ironsteel/apple-ice/README.md

# Apple-iCE

## Apple II peripheral card prototype which aims to be multi purpose

# Work in progess
