ironsteel/apple-ice/rtl/liron/README.md

Liron clone for the Apple ][ iCE board
============

## Introduction

RTL of the liron card clone based on Steve Chamberlin's initial design
with some minor tweaks.
