ironsteel/apple-ice/hardware/apple-ice.kicad_pcb

## KiCad design hardware/apple-ice.kicad_pcb (2021-10-15)

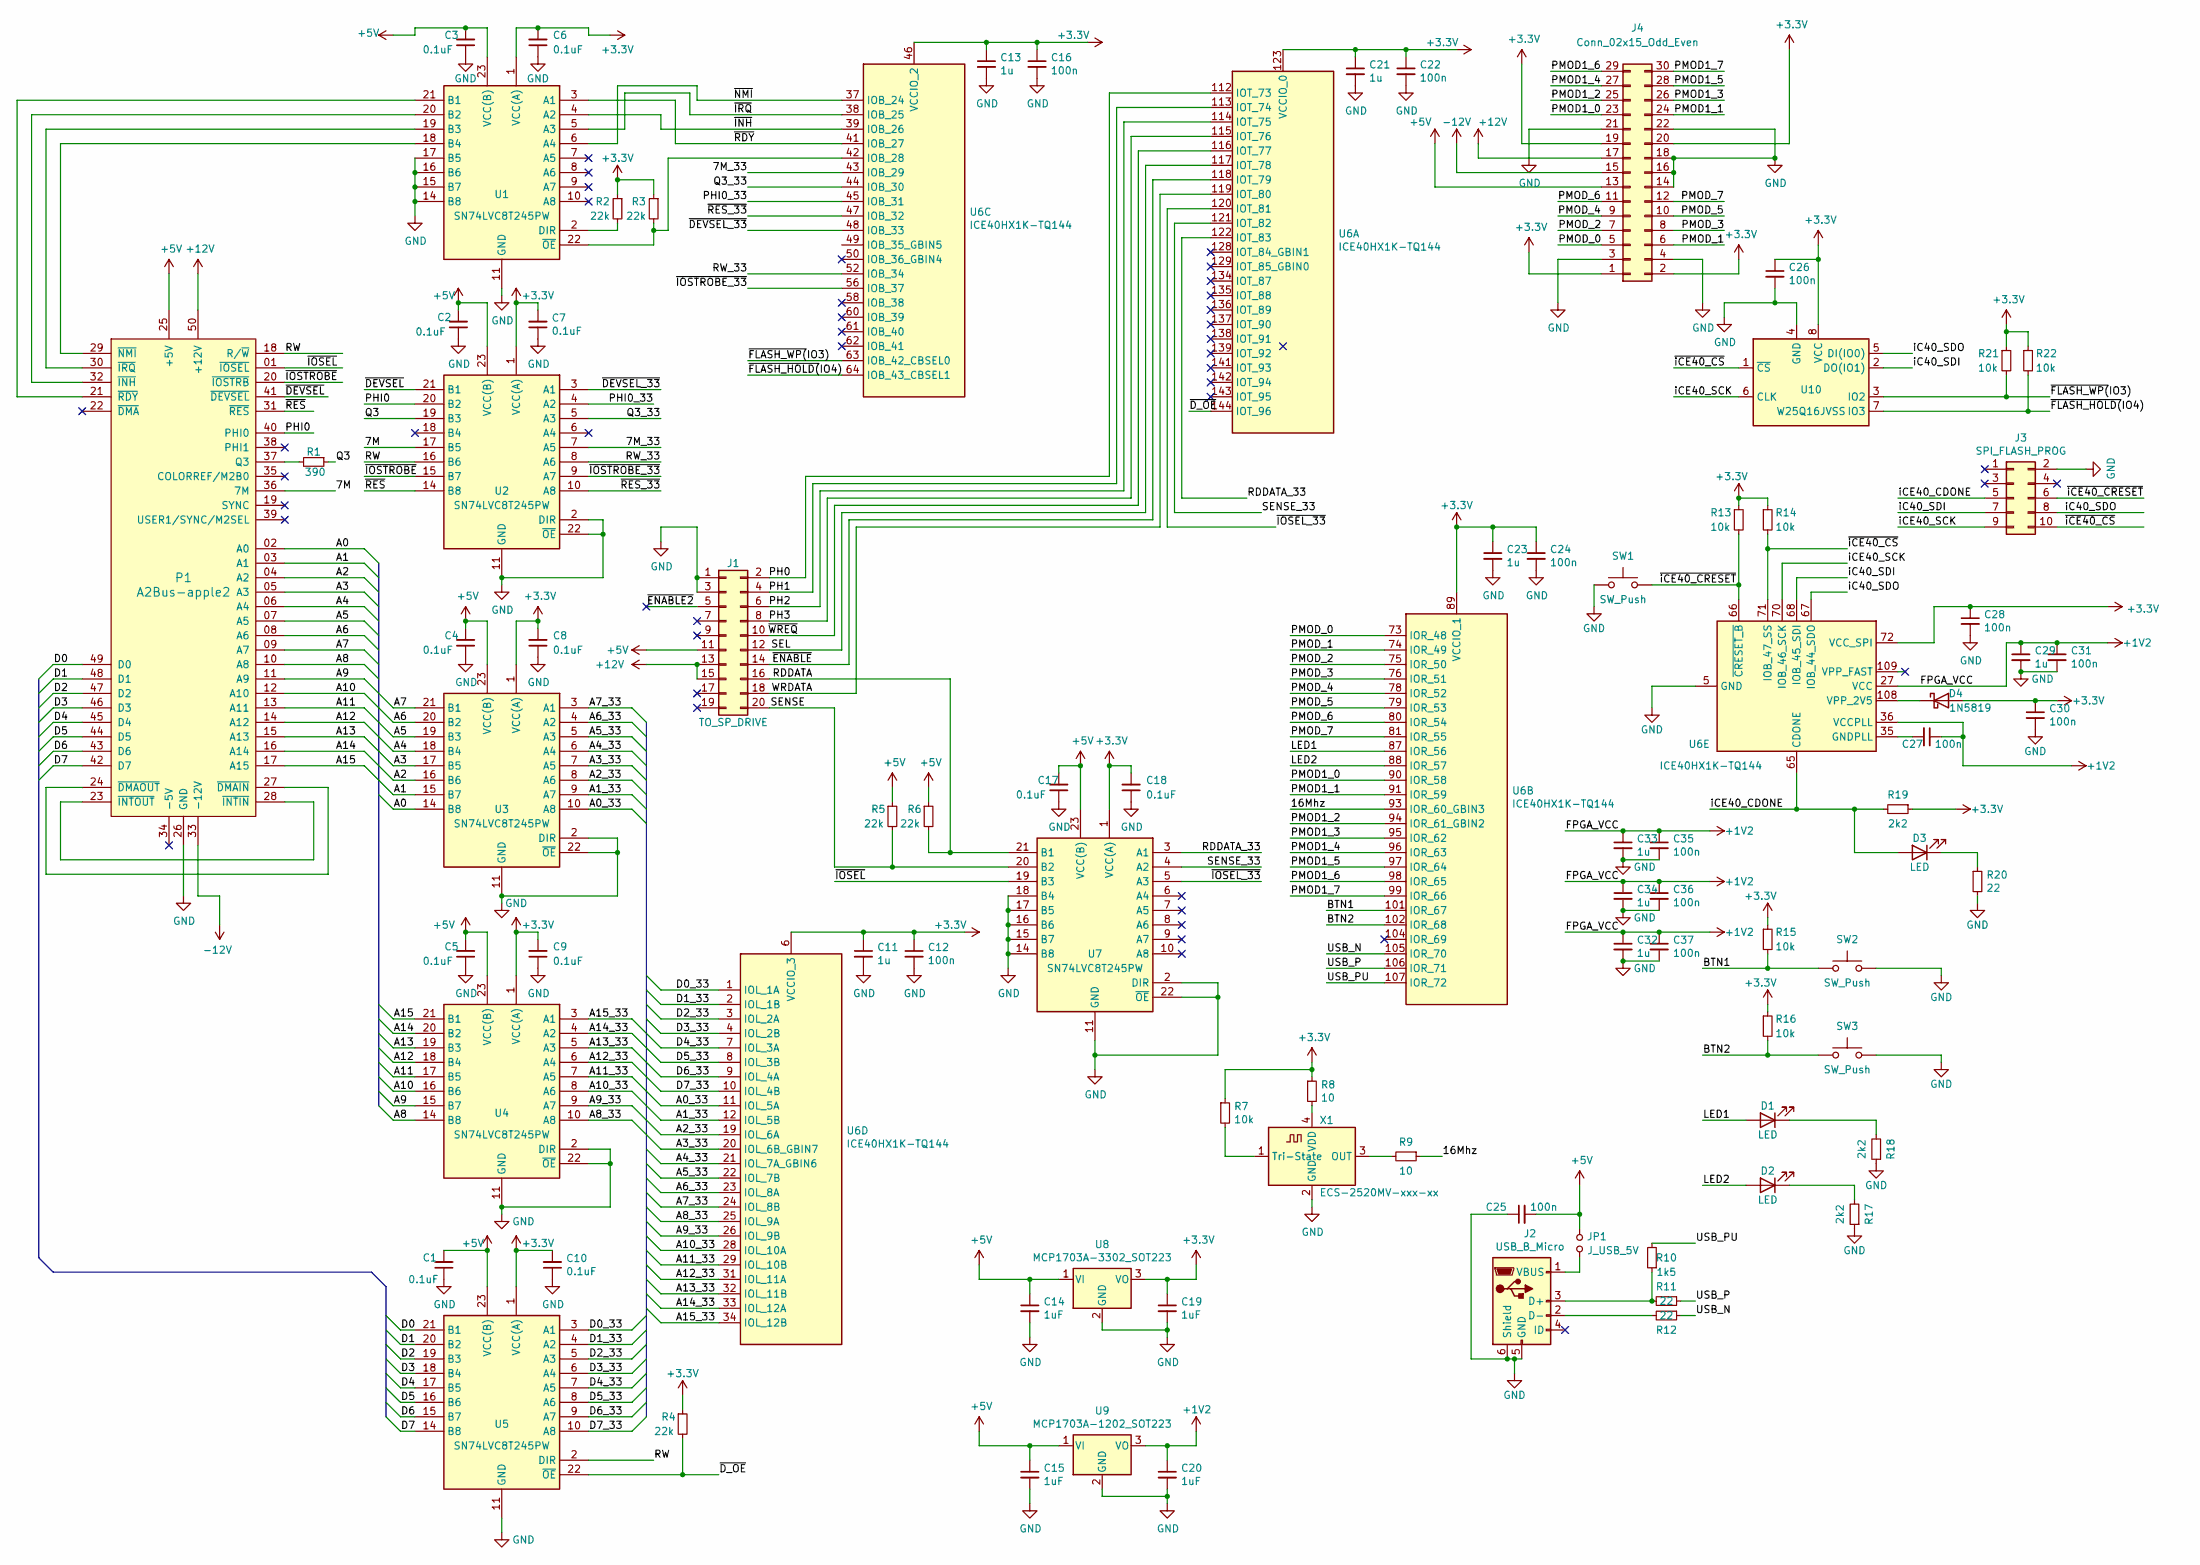
[picture p1: schematic apple-ice.sch, Apple ][ iCE]

Parts:
C1, C2, C3, C4, C5, C6, C7, C8, C9, C10, C17, C18: 0.1uF; C_0603_1608Metric_Pad1.08x0.95mm_HandSolder
C11, C13, C21, C23, C29, C32, C33, C34: 1u; C_0603_1608Metric_Pad1.08x0.95mm_HandSolder
C12, C16, C22, C24, C25, C26, C27, C28, C30, C31, C35, C36, C37: 100n; C_0603_1608Metric_Pad1.08x0.95mm_HandSolder
C14, C15, C19, C20: 1uF; C_0603_1608Metric_Pad1.08x0.95mm_HandSolder
D1, D2, D3: LED; LED_0603_1608Metric
D4: 1N5819; D_SOD-123
J1: TO_SP_DRIVE; IDC-Header_2x10_P2.54mm_Vertical
J2: USB_B_Micro; MOLEX-0475890001
J3: SPI_FLASH_PROG; IDC-Header_2x05_P2.54mm_Vertical
J4: Conn_02x15_Odd_Even; PinSocket_2x15_P2.54mm_Horizontal
JP1: J_USB_5V; C_0603_1608Metric_Pad1.08x0.95mm_HandSolder
P1: A2Bus-apple2; A2-50PIN-MINI
R1: 390; R_0603_1608Metric_Pad0.98x0.95mm_HandSolder
R2, R3, R4, R5, R6: 22k; R_0603_1608Metric_Pad0.98x0.95mm_HandSolder
R7, R13, R14, R15, R16, R21, R22: 10k; R_0603_1608Metric_Pad0.98x0.95mm_HandSolder
R8, R9: 10; R_0603_1608Metric_Pad0.98x0.95mm_HandSolder
R10: 1k5; R_0603_1608Metric_Pad0.98x0.95mm_HandSolder
R11, R12, R20: 22; R_0603_1608Metric_Pad0.98x0.95mm_HandSolder
R17, R18, R19: 2k2; R_0603_1608Metric_Pad0.98x0.95mm_HandSolder
SW1, SW2, SW3: SW_Push; SW_SPST_B3S-1000
U1, U2, U3, U4, U5, U7: SN74LVC8T245PW; TSSOP-24_4.4x7.8mm_P0.65mm
U6: ICE40HX1K-TQ144; TQFP-144_20x20mm_P0.5mm
U8: MCP1703A-3302_SOT223; SOT-223-3_TabPin2
U9: MCP1703A-1202_SOT223; SOT-223-3_TabPin2
U10: W25Q16JVSS; SOIC-8_5.23x5.23mm_P1.27mm
X1: ECS-2520MV-xxx-xx; Oscillator_SMD_ECS_2520MV-xxx-xx-4Pin_2.5x2.0mm

Connections:
+1V2: C20.1, C27.1, C29.1, C31.1, C32.1, C33.1, C34.1, C35.1, C36.1, C37.1, U6.27 (VCC), U6.36 (VCCPLL), U6.51 (VCC), U6.92 (VCC), U6.111 (VCC), U9.3 (VO)
+3.3V: C6.2, C7.2, C8.2, C9.2, C10.2, C11.1, C12.1, C13.1, C16.1, C18.2, C19.1, C21.1, C22.1, C23.1, C24.1, C26.1, C28.1, C30.1, D4.2 (A), J4.1, J4.2, J4.19, J4.20, R2.1, R3.1, R4.1, R7.1, R8.1, R13.1, R14.1, R15.1, R16.1, R19.1, R21.1, R22.1, U1.1 (VCC(A)), U2.1 (VCC(A)), U3.1 (VCC(A)), U4.1 (VCC(A)), U5.1 (VCC(A)), U6.6 (VCCIO_3), U6.30 (VCCIO_3), U6.46 (VCCIO_2), U6.57 (VCCIO_2), U6.72 (VCC_SPI), U6.89 (VCCIO_1), U6.100 (VCCIO_1), U6.123 (VCCIO_0), U6.133 (VCCIO_0), U7.1 (VCC(A)), U8.3 (VO), U10.8 (VCC)
+5V: C1.2, C2.2, C3.2, C4.2, C5.2, C14.1, C15.1, C17.2, C25.2, J1.11, J4.13, JP1.1, P1.25 (+5V), R5.1, R6.1, U1.23 (VCC(B)), U1.24 (VCC(B)), U2.23 (VCC(B)), U2.24 (VCC(B)), U3.23 (VCC(B)), U3.24 (VCC(B)), U4.23 (VCC(B)), U4.24 (VCC(B)), U5.23 (VCC(B)), U5.24 (VCC(B)), U7.23 (VCC(B)), U7.24 (VCC(B)), U8.1 (VI), U9.1 (VI)
-12V: J4.15, P1.33 (-12V)
/7M: P1.36 (7M), U2.17 (B5)
/7M_33: U2.7 (A5), U6.43 (IOB_29)
/16Mhz: R9.1, U6.93 (IOR_60_GBIN3)
/A0: P1.02 (A0), U3.14 (B8)
/A0_33: U3.10 (A8), U6.11 (IOL_5A)
/A1: P1.03 (A1), U3.15 (B7)
/A1_33: U3.9 (A7), U6.12 (IOL_5B)
/A2: P1.04 (A2), U3.16 (B6)
/A2_33: U3.8 (A6), U6.19 (IOL_6A)
/A3: P1.05 (A3), U3.17 (B5)
/A3_33: U3.7 (A5), U6.20 (IOL_6B_GBIN7)
/A4: P1.06 (A4), U3.18 (B4)
/A4_33: U3.6 (A4), U6.21 (IOL_7A_GBIN6)
/A5: P1.07 (A5), U3.19 (B3)
/A5_33: U3.5 (A3), U6.22 (IOL_7B)
/A6: P1.08 (A6), U3.20 (B2)
/A6_33: U3.4 (A2), U6.23 (IOL_8A)
/A7: P1.09 (A7), U3.21 (B1)
/A7_33: U3.3 (A1), U6.24 (IOL_8B)
/A8: P1.10 (A8), U4.14 (B8)
/A8_33: U4.10 (A8), U6.25 (IOL_9A)
/A9: P1.11 (A9), U4.15 (B7)
/A9_33: U4.9 (A7), U6.26 (IOL_9B)
/A10: P1.12 (A10), U4.16 (B6)
/A10_33: U4.8 (A6), U6.28 (IOL_10A)
/A11: P1.13 (A11), U4.17 (B5)
/A11_33: U4.7 (A5), U6.29 (IOL_10B)
/A12: P1.14 (A12), U4.18 (B4)
/A12_33: U4.6 (A4), U6.31 (IOL_11A)
/A13: P1.15 (A13), U4.19 (B3)
/A13_33: U4.5 (A3), U6.32 (IOL_11B)
/A14: P1.16 (A14), U4.20 (B2)
/A14_33: U4.4 (A2), U6.33 (IOL_12A)
/A15: P1.17 (A15), U4.21 (B1)
/A15_33: U4.3 (A1), U6.34 (IOL_12B)
/BTN1: R15.2, SW2.1, U6.101 (IOR_67)
/BTN2: R16.2, SW3.1, U6.102 (IOR_68)
/D0: P1.49 (D0), U5.21 (B1)
/D0_33: U5.3 (A1), U6.1 (IOL_1A)
/D1: P1.48 (D1), U5.20 (B2)
/D1_33: U5.4 (A2), U6.2 (IOL_1B)
/D2: P1.47 (D2), U5.19 (B3)
/D2_33: U5.5 (A3), U6.3 (IOL_2A)
/D3: P1.46 (D3), U5.18 (B4)
/D3_33: U5.6 (A4), U6.4 (IOL_2B)
/D4: P1.45 (D4), U5.17 (B5)
/D4_33: U5.7 (A5), U6.7 (IOL_3A)
/D5: P1.44 (D5), U5.16 (B6)
/D5_33: U5.8 (A6), U6.8 (IOL_3B)
/D6: P1.43 (D6), U5.15 (B7)
/D6_33: U5.9 (A7), U6.9 (IOL_4A)
/D7: P1.42 (D7), U5.14 (B8)
/D7_33: U5.10 (A8), U6.10 (IOL_4B)
/LED1: D1.2 (A), U6.87 (IOR_56)
/LED2: D2.2 (A), U6.88 (IOR_57)
/PH0: J1.2, U6.112 (IOT_73)
/PH1: J1.4, U6.113 (IOT_74)
/PH2: J1.6, U6.114 (IOT_75)
/PH3: J1.8, U6.115 (IOT_76)
/PHI0: P1.40 (PHI0), U2.20 (B2)
/PHI0_33: U2.4 (A2), U6.45 (IOB_31)
/PMOD1_0: J4.23, U6.90 (IOR_58)
/PMOD1_1: J4.24, U6.91 (IOR_59)
/PMOD1_2: J4.25, U6.94 (IOR_61_GBIN2)
/PMOD1_3: J4.26, U6.95 (IOR_62)
/PMOD1_4: J4.27, U6.96 (IOR_63)
/PMOD1_5: J4.28, U6.97 (IOR_64)
/PMOD1_6: J4.29, U6.98 (IOR_65)
/PMOD1_7: J4.30, U6.99 (IOR_66)
/PMOD_0: J4.5, U6.73 (IOR_48)
/PMOD_1: J4.6, U6.74 (IOR_49)
/PMOD_2: J4.7, U6.75 (IOR_50)
/PMOD_3: J4.8, U6.76 (IOR_51)
/PMOD_4: J4.9, U6.78 (IOR_52)
/PMOD_5: J4.10, U6.79 (IOR_53)
/PMOD_6: J4.11, U6.80 (IOR_54)
/PMOD_7: J4.12, U6.81 (IOR_55)
/Q3: R1.1, U2.19 (B3)
/Q3_33: U2.5 (A3), U6.44 (IOB_30)
/RDDATA: J1.16, R6.2, U7.21 (B1)
/RDDATA_33: U6.122 (IOT_83), U7.3 (A1)
/RW: P1.18 (R/~W), U2.16 (B6), U5.2 (DIR)
/RW_33: U2.8 (A6), U6.52 (IOB_34)
/SEL: J1.12, U6.117 (IOT_78)
/SENSE: J1.20, R5.2, U7.20 (B2)
/SENSE_33: U6.121 (IOT_82), U7.4 (A2)
/USB_N: R12.1, U6.105 (IOR_70)
/USB_P: R11.1, U6.106 (IOR_71)
/USB_PU: R10.2, U6.107 (IOR_72)
/WRDATA: J1.18, U6.119 (IOT_80)
/iC40_SDI: J3.7, U6.68 (IOB_45_SDI), U10.2 (DO(IO1))
/iC40_SDO: J3.8, U6.67 (IOB_44_SDO), U10.5 (DI(IO0))
/iCE40_CDONE: D3.2 (A), J3.5, R19.2, U6.65 (CDONE)
/iCE40_SCK: J3.9, U6.70 (IOB_46_SCK), U10.6 (CLK)
/~DEVSEL: P1.41 (~DEVSEL), U2.21 (B1)
/~DEVSEL_33: U2.3 (A1), U6.48 (IOB_33)
/~D_OE: R4.2, U5.22 (~OE), U6.144 (IOT_96)
/~ENABLE: J1.14, U6.118 (IOT_79)
/~ENABLE2: J1.5
/~FLASH_HOLD(~IO4): R22.2, U6.64 (IOB_43_CBSEL1), U10.7 (IO3)
/~FLASH_WP(~IO3): R21.2, U6.63 (IOB_42_CBSEL0), U10.3 (IO2)
/~INH: U1.4 (A2), U6.39 (IOB_26)
/~IOSEL: P1.01 (~IOSEL), U7.19 (B3)
/~IOSEL_33: U6.120 (IOT_81), U7.5 (A3)
/~IOSTROBE: P1.20 (~IOSTRB), U2.15 (B7)
/~IOSTROBE_33: U2.9 (A7), U6.56 (IOB_37)
/~IRQ: U1.5 (A3), U6.38 (IOB_25)
/~NMI: U1.6 (A4), U6.37 (IOB_24)
/~RDY: U1.3 (A1), U6.41 (IOB_27)
/~RES: P1.31 (~RES), U2.14 (B8)
/~RES_33: U2.10 (A8), U6.47 (IOB_32)
/~WREQ: J1.10, U6.116 (IOT_77)
/~iCE40_CRESET: J3.6, R13.2, SW1.2, U6.66 (~CRESET_B)
/~iCE40_CS: J3.10, R14.2, U6.71 (IOB_47_SS), U10.1 (~CS)
unnamed: C27.2, U6.35 (GNDPLL)
unnamed: D1.1 (K), R18.2
unnamed: D2.1 (K), R17.2
unnamed: D3.1 (K), R20.1
unnamed: D4.1 (K), U6.108 (VPP_2V5)
unnamed: J2.1 (VBUS), JP1.2
unnamed: J2.2 (D-), R12.2
unnamed: J2.3 (D+), R10.1, R11.2
unnamed: P1.21 (~RDY), U1.21 (B1)
unnamed: P1.23 (~INTOUT), P1.28 (~INTIN)
unnamed: P1.24 (~DMAOUT), P1.27 (~DMAIN)
unnamed: P1.29 (~NMI), U1.18 (B4)
unnamed: P1.30 (~IRQ), U1.19 (B3)
unnamed: P1.32 (~INH), U1.20 (B2)
unnamed: P1.37 (Q3), R1.2
unnamed: R2.2, U1.2 (DIR)
unnamed: R3.2, U1.22 (~OE), U6.42 (IOB_28)
unnamed: R7.2, X1.1 (Tri-State)
unnamed: R8.2, X1.4 (VDD)
unnamed: R9.2, X1.3 (OUT)

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
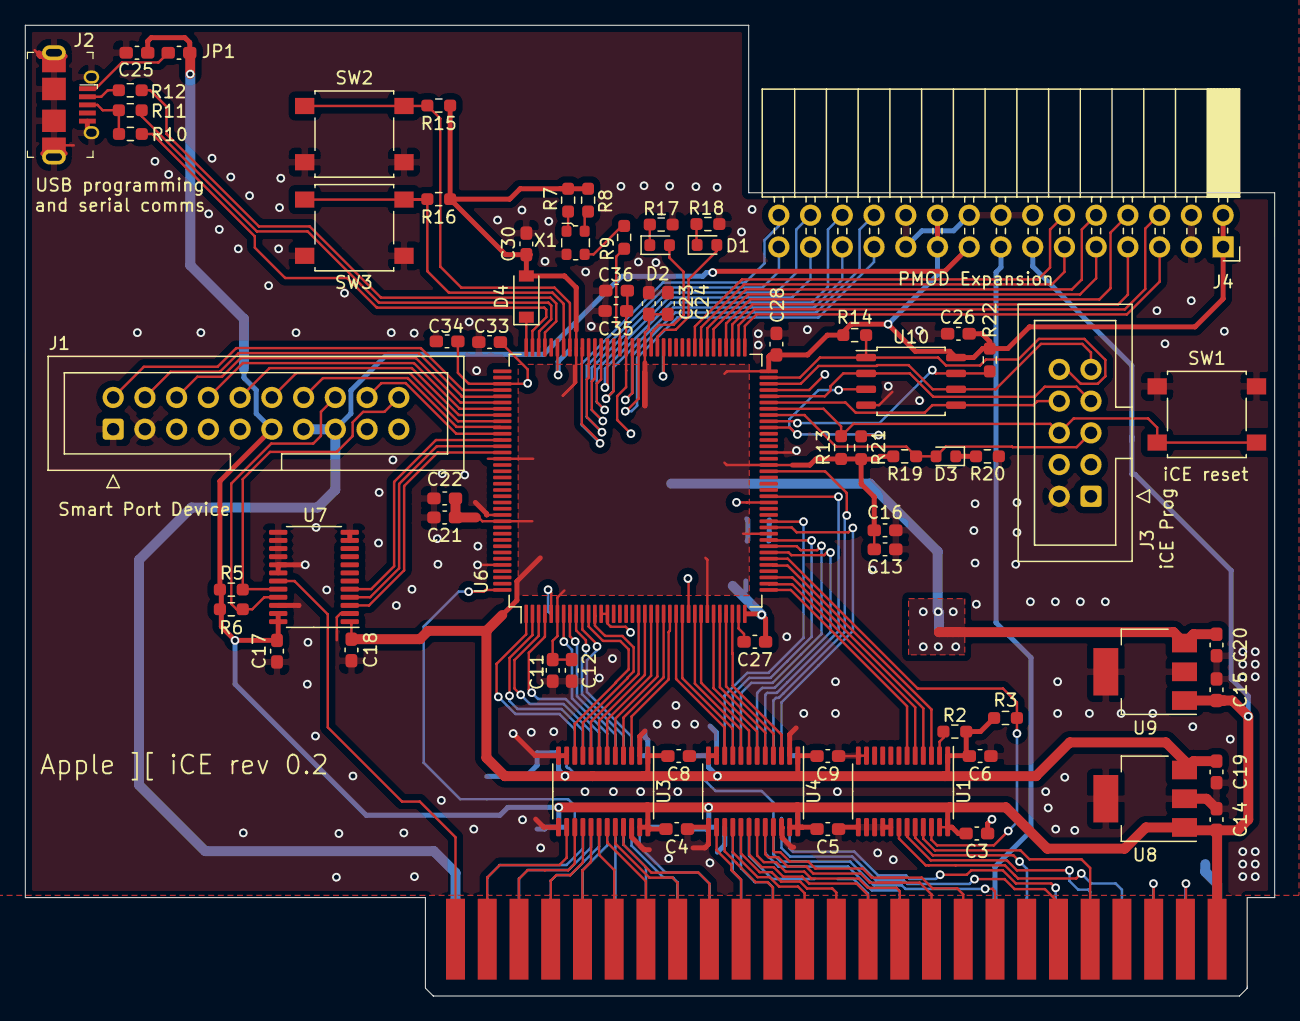
[picture p2: board apple-ice.kicad_pcb from above]

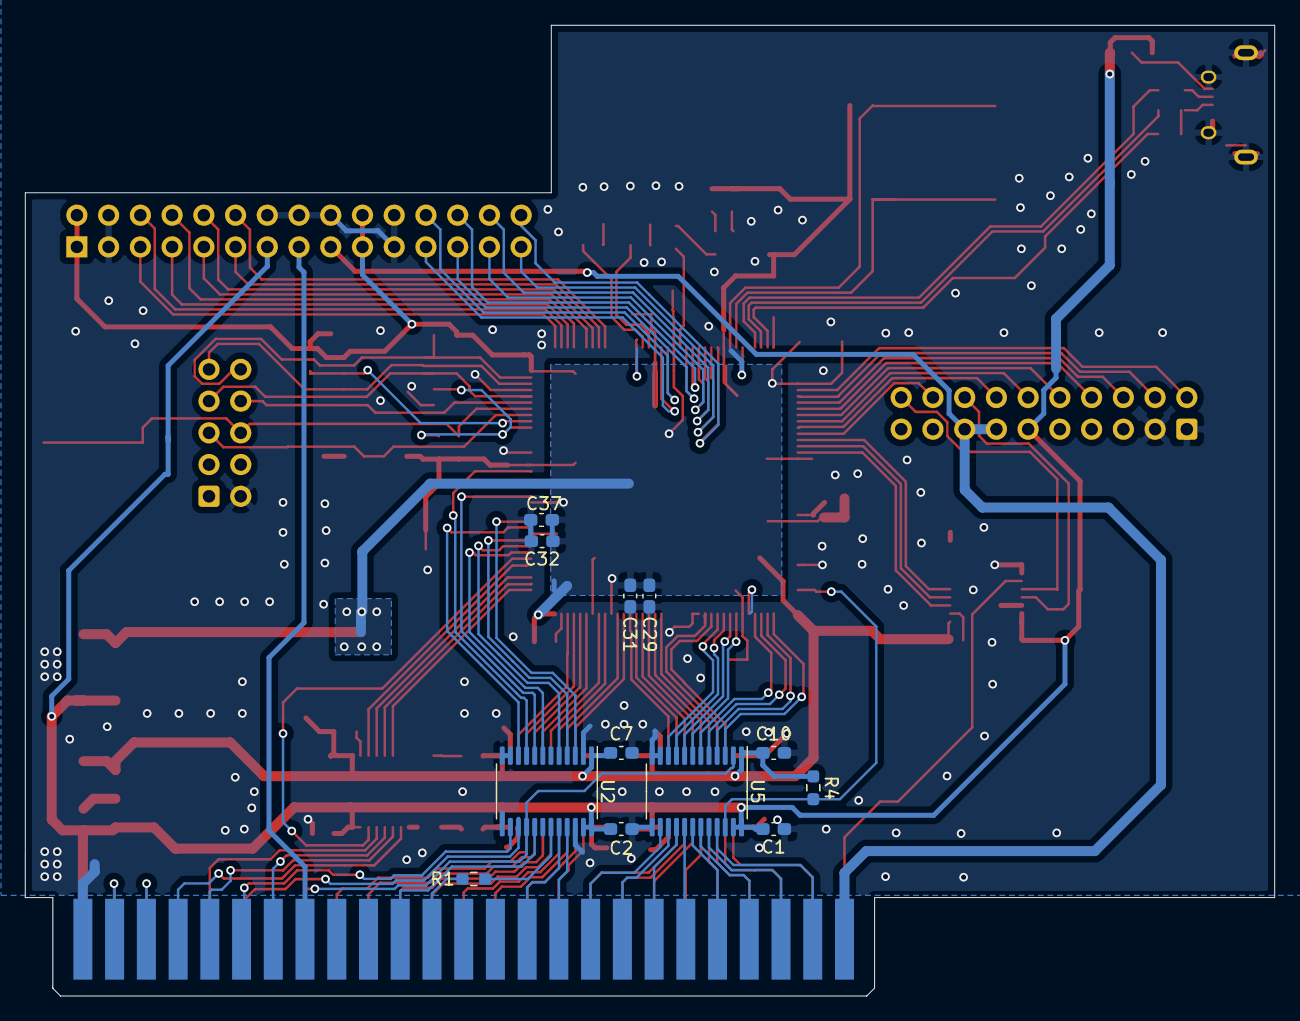
[picture p3: board apple-ice.kicad_pcb from below]

Board: 2 copper layers, 100.0 x 77.7 mm, 83 parts (12 on the bottom side), 139 nets.
