ironsteel/apple-ice/(commit log)

2021-05-08 Initial commit
    Initial kicad project
    [apple-ice.kicad_pcb, apple-ice.sch]
2021-05-08 Add footprints for ice40 FPGA and apple II bus connector
    [apple-ice.sch]
2021-05-15 Add apple 2 bus/cardedge symbol
    [apple-ice.sch]
2021-05-17 Symbols and footprints
    [apple-ice.sch]
2021-05-27 Apple II connections part complete
    Edge cuts for board, initial placement of buffers
    [apple-ice.kicad_pcb, apple-ice.sch]
2021-06-06 FPGA programming and power
    Reorginize schematic
    Add more footprints and symbols
    [apple-ice.kicad_pcb, apple-ice.sch]
2021-06-08 Begin initial placement and routing
    [apple-ice.kicad_pcb, apple-ice.sch]
2021-10-15 Initial placement V2
    [apple-ice.kicad_pcb, apple-ice.sch]
2021-10-15 Add new micro USB footprint
    [apple-ice.kicad_pcb, apple-ice.sch]
2021-10-15 More schematic tweaking for easier routing
    [apple-ice.kicad_pcb, apple-ice.sch]
2021-10-15 More routing, 80% finished
    [apple-ice.kicad_pcb, apple-ice.sch]
2021-10-15 Finish routing
    [apple-ice.kicad_pcb, apple-ice.sch]
2021-10-15 Remove some vias
    [apple-ice.kicad_pcb]
2021-10-15 Add 2x15 pin header
    [apple-ice.kicad_pcb, apple-ice.sch]
2021-10-15 Route double pmod header
    [apple-ice.kicad_pcb, apple-ice.sch]
2021-10-15 Add 5, 12 and -12 power rails to pmod connection
    [apple-ice.kicad_pcb, apple-ice.sch]
2021-10-15 Add some useful text to the PCB
    [apple-ice.kicad_pcb]
2021-10-15 Move via out of silk screen text
    [apple-ice.kicad_pcb]
2021-10-15 Add interective bom
2021-10-15 Move io_strobe signal to an FPGA pin that is not shared with the PLL
    [apple-ice.kicad_pcb, apple-ice.sch]
2021-10-15 Rev 0.2
    [apple-ice.kicad_pcb, apple-ice.sch]
2021-12-27 Liron clone based on the design of Steve Chamberlin from BMOW
    With some minor tweaks so it works on my apple II clones (pravetz)
